Picott/ARpet/diseno/documento.html

# Ménsula Alféizar

Repisa para gatos que se cuelga de la ventana sin taladrar ni ventosas: engancha el labio interior del marco de aluminio y se apoya en la pared. Ajustable en profundidad de alféizar, altura de labio y nivel.

rev. A · prototipo 1
carga de diseño 29 kgf
cuerpo contrachapado 18 mm
anclaje fleje acero 50×3

## 01Cómo se sostiene

El gato carga el brazo en voladizo. Ese momento quiere levantar la lengüeta del alféizar y clavar la pata contra la pared. Dos cosas lo equilibran:

- El pie contra la pared, a una altura h bajo el alféizar. Cuanto más baja la pata, menor la fuerza. Con h = 320 mm y voladizo L = 320 mm, el empuje total es igual al peso que carga.
- El diente del fleje, que entra en el canal detrás del labio interior del marco de aluminio. Es lo único que impide que todo el conjunto deslice hacia la habitación. Sin ese diente, ninguna repisa de alféizar con apoyo en pared se sostiene: el alféizar y la pared solo pueden empujar hacia el cuarto.

La goma bajo la lengüeta añade fricción que descarga al diente, pero no se cuenta en el cálculo: el diseño se sostiene aunque el alféizar esté pulido.

Regla de bolsillo: N = W · L / h. Empuje en la pared y tiro en el gancho son la misma fuerza N. Un gato de 6 kg que salta genera picos de unos 18 kgf; con margen 1,6 la carga de diseño queda en 29 kgf.

Vista lateral. El peso W del gato se equilibra con el empuje del pie contra la pared y el tiro del diente en el labio del marco. Giro alrededor de la arista del alféizar.

## 02Calculadora

Peso del gato (kg) Voladizo L (mm) Altura del pie h (mm) Factor dinámico × seguridad

Límites usados: fleje acero 150 MPa, labio de aluminio 6063 (1,4 mm) 100 MPa, contrachapado de abedul 30 MPa, pared de yeso 3 kgf/cm². Son valores conservadores para prototipo, no una norma.

## 03Qué se ajusta y cuánto

Variable de la ventana | Cómo se ajusta | Rango
Profundidad del alféizar (de la pared al labio del marco) | El fleje desliza por una ranura de 100 mm bajo dos palomillas M6; la lengüeta del cuerpo aporta otros 30 mm | 30 – 190 mm
Altura del labio del marco sobre el alféizar | El fleje va en un rebaje a 40 mm; el diente de 25 mm baja detrás del labio | ≤ 40 mm
Canal detrás del labio | Diente de 3 mm de espesor, 50 mm de ancho; se coloca donde la hoja corredera no pasa | ≥ 5 mm de hueco
Pared no vertical, zócalo o irregularidad | Pie con tornillo M8 en tuerca de golpe: cambia la separación y nivela el brazo | 10 – 25 mm
Ancho de la ventana | Dos ménsulas en cualquier posición bajo la tabla; tabla de 600 mm estándar, 900 opcional | 400 – 500 mm entre ménsulas
Nivel fino | Goma de 3 mm bajo la lengüeta más el pie regulable | ± 1°

Lo que no cubre esta revisión: alféizares que sobresalen de la pared más de 10 mm (la pata no apoya) y ventanas de madera o PVC sin labio interior. Para esos casos la revisión B lleva una mordaza bajo el vuelo del alféizar en vez del diente. Mide tu ventana con la lista del final antes de cortar nada.

## 04Piezas

Cuerpo Pie de pared Mordaza del fleje

cargando modelo…

Arrastra para girar, rueda o pellizco para acercar. Los STL y las plantillas SVG están en la carpeta diseno/salida del repositorio; el generador diseno/mensula.py los rehace con otras medidas.

### Cuerpo de la ménsula (×2)

Contrachapado de abedul de 18 mm cortado con la plantilla 1:1 (sierra de calar o CNC). Brazo de 320 mm con rebaje de 3 mm para el fleje, lengüeta de 30 mm sobre el alféizar, pata de 320 mm separada 10 mm de la pared y tirante diagonal. Dos taladros verticales Ø6,5 para el fleje y uno horizontal Ø8,5 para la tuerca de golpe del pie. También se puede imprimir en PETG en dos mitades con cola de milano, pero el contrachapado es más barato y más rígido.

### Fleje-gancho (×2)

Pletina de acero de 50×3 mm, 218 mm de largo, con ranura de 100×6,5 y doblez a 90° que forma el diente de 25 mm. Lo corta y dobla cualquier taller de cerrajería en minutos. Pintado o galvanizado.

### Pie de pared (×2, impreso)

Disco Ø44×14 mm en PETG con alojamiento hexagonal para la cabeza de un tornillo M8×50 y cazoleta para un disco de goma de 3 mm. El tornillo rosca en una tuerca de golpe M8 clavada en la pata; girándolo se regula la separación y se nivela.

### Mordaza del fleje (×2, impresa)

Barra de 100×46×6 mm que reparte el apriete de las dos palomillas M6 sobre la ranura del fleje para que no se marque ni deslice.

### Tabla y colchoneta

Contrachapado de 15 mm, 600×320 mm, cantos redondeados, atornillada desde arriba a los brazos con 4 tornillos de 4×40. Colchoneta de 600×320 con funda lavable y velcro en las cuatro esquinas.

Plantilla del perfil (archivo mensula_perfil_1a1.svg, imprimir al 100 %).

Desarrollo del fleje (archivo fleje_gancho_1a1.svg).

## 05Lista de materiales del prototipo

Pieza | Material y medida | Cant. | USD aprox.
Cuerpo de ménsula | Contrachapado abedul 18 mm, retal 400×400 | 2 | 8
Tabla | Contrachapado 15 mm, 600×320 | 1 | 6
Fleje-gancho | Pletina acero 50×3, 218 mm, cortada, ranurada y doblada | 2 | 6
Pie de pared | PETG impreso, 16 cm³, más disco de goma Ø40×3 | 2 | 2
Mordaza del fleje | PETG impreso, 27 cm³ | 2 | 1.5
Tornillería | 4 M6×60 con palomilla y arandela, 2 M8×50 con tuerca de golpe y contratuerca, 4 tornillos 4×40 | 1 lote | 5
Goma | Tira EPDM 3 mm bajo la lengüeta y bajo la tabla | 1 | 2
Colchoneta | Espuma 30 mm con funda lavable y velcro | 1 | 10
Acabado | Aceite o barniz al agua, lija | 1 | 3
Total prototipo | | | ≈ 44

En producción (corte CNC en lote, fleje troquelado, pies inyectados) el coste de materiales cae a 18 a 22 USD, lo que permite un precio de venta entre 60 y 80 USD. Las camas de ventana con ventosas se venden entre 25 y 45 USD, así que el argumento tiene que ser seguridad y madera, no precio.

## 06Montaje

1. Imprime la plantilla al 100 %, pégala al contrachapado y corta los dos cuerpos. Lija cantos y taladra los tres agujeros de cada uno.
2. Clava la tuerca de golpe M8 en la cara de la pata que mira a la pared. Rosca el tornillo M8 con el pie impreso y la contratuerca.
3. Pega la tira de goma bajo la lengüeta. Coloca el fleje en el rebaje, pasa los M6 desde abajo, pon la mordaza encima y las palomillas sin apretar.
4. Presenta cada ménsula en la ventana: el diente entra en el canal detrás del labio, la lengüeta apoya en el alféizar, el pie toca la pared. Desliza el fleje hasta que el diente quede pegado al labio y aprieta las palomillas.
5. Gira el tornillo del pie hasta que el brazo quede horizontal (nivel de burbuja encima). Bloquea con la contratuerca.
6. Atornilla la tabla desde arriba a los dos brazos, separados 450 mm. Pon la colchoneta. Carga con tu propio peso de la mano unos 20 kg en la punta antes de dejar subir al gato.

## 07Protocolo de pruebas antes de vender una sola unidad

Prueba | Cómo | Pasa si
Carga estática | Saco de 30 kg en el borde exterior de la tabla durante 24 h | Nada se afloja, flecha en la punta menor de 5 mm y vuelve a cero
Carga dinámica | Dejar caer 6 kg desde 40 cm sobre la punta, 50 veces | Diente sin deformar, palomillas sin perder apriete, labio del marco sin marca
Deslizamiento | Empujar la tabla hacia la habitación con 15 kgf | Desplazamiento cero: el diente trabaja
Pared | Retirar tras 2 semanas de uso | Sin marca permanente en pintura mate con el disco de goma
Compatibilidad | Montar en 3 ventanas distintas de aluminio corredera | Encaja con el rango de ajuste sin modificar piezas; la hoja corredera no roza el diente
Uso real | Dos gatos durante un mes | Suben por sí solos, cero incidentes, cero reajustes

## 08Medidas que necesito de tu ventana

- Profundidad del alféizar: de la cara de la pared interior al labio del marco de aluminio.
- Altura del labio: cuánto sobresale el marco por encima del alféizar.
- Hueco del canal: anchura del hueco justo detrás del labio y si la hoja corredera pasa por ahí.
- Vuelo del alféizar: si la piedra o el mármol sobresale de la pared y cuánto.
- Pared bajo la ventana: material, si hay zócalo o tubería a menos de 35 cm.
- Ancho libre de la ventana y a qué altura del suelo está el alféizar.
- Peso de tus gatos y si saltan desde el suelo o desde un mueble.

Con esas siete medidas fijo los parámetros del generador, regenero STL y plantillas, y pasamos a cortar. Si el alféizar sobresale o no hay labio, cambio el anclaje a la revisión B (mordaza) antes de que compres material.
