Picott/ARpet/diseno/salida/mensula_cuerpo.stl

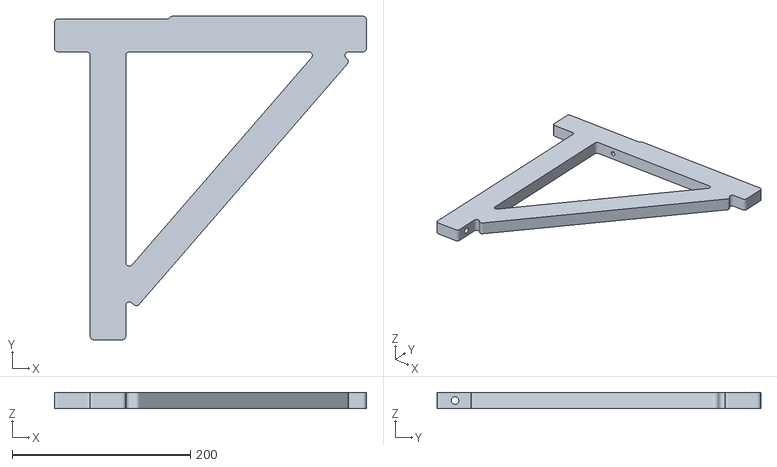
[picture p1: CAD file, 2026-10-30]
diseno/salida/mensula_cuerpo.stl
350.0 x 363.0 x 18.0
