Picott/ARpet/diseno/salida/pie_pared.stl

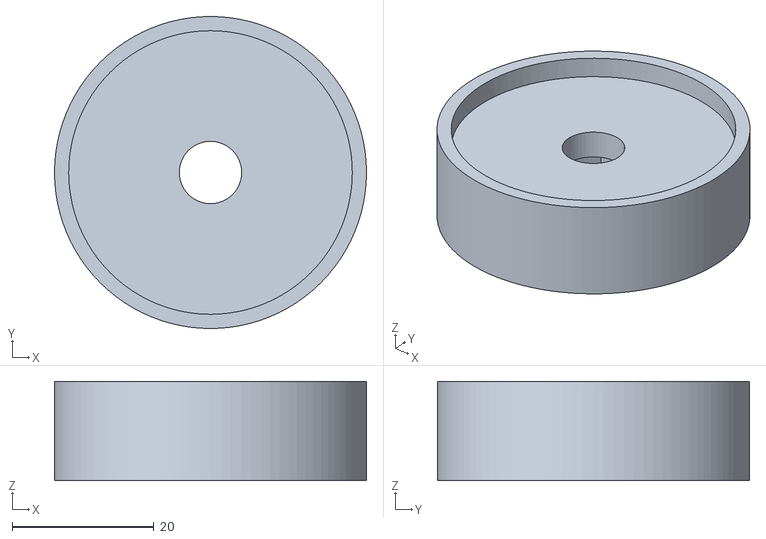
[picture p2: CAD file, 2026-10-30]
diseno/salida/pie_pared.stl
44.0 x 44.0 x 14.0
