Picott/ARpet/diseno/salida/mordaza_fleje.stl

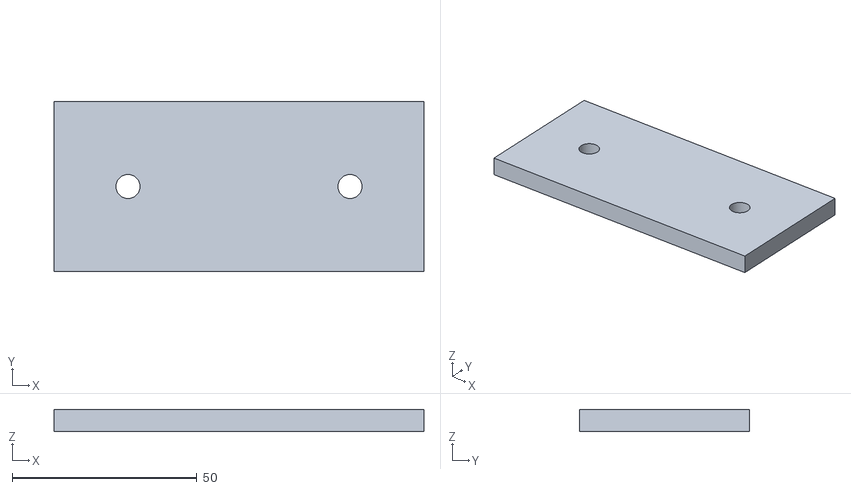
[picture p3: CAD file, 2026-10-30]
diseno/salida/mordaza_fleje.stl
100.0 x 46.0 x 6.00
