Picott/ARpet/(commit log)

2026-10-29 Añadir prototipo Holopet: mascota holográfica en pedestal
    Un solo archivo HTML con Three.js (CDN) que renderiza el pedestal y la
    mascota como holograma, con chat de texto y voz (Web Speech API),
    acciones (acariciar, alimentar, jugar, dormir), inteligencia simulada
    por reglas con memoria en localStorage, estados internos, proactividad,
    evolución por etapas, modo feral configurable, modo fiesta (Web Audio)
    y varios pedestales. Incluye la sección "Versión física" con la
    especificación de hardware y el coste estimado.
    Claude-Session: https://claude.ai/code/session_013cvsSq3DrKMyAbUF2KK2Ru
2026-10-30 Añadir diseño paramétrico de la ménsula de alféizar para gatos
    Generador en Python (trimesh) que produce el cuerpo, el pie regulable y
    la mordaza en STL, las plantillas SVG 1:1 del perfil y del fleje-gancho,
    y el cálculo estático. Incluye el documento de diseño con visor 3D,
    calculadora, lista de materiales, montaje y protocolo de pruebas.
    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
    [mensula_cuerpo.stl, mordaza_fleje.stl, pie_pared.stl]
